r00tkillah/BLINKERCOUGH/pcb/blinkercough.brd

## EAGLE design pcb/blinkercough.brd (2015-08-11)

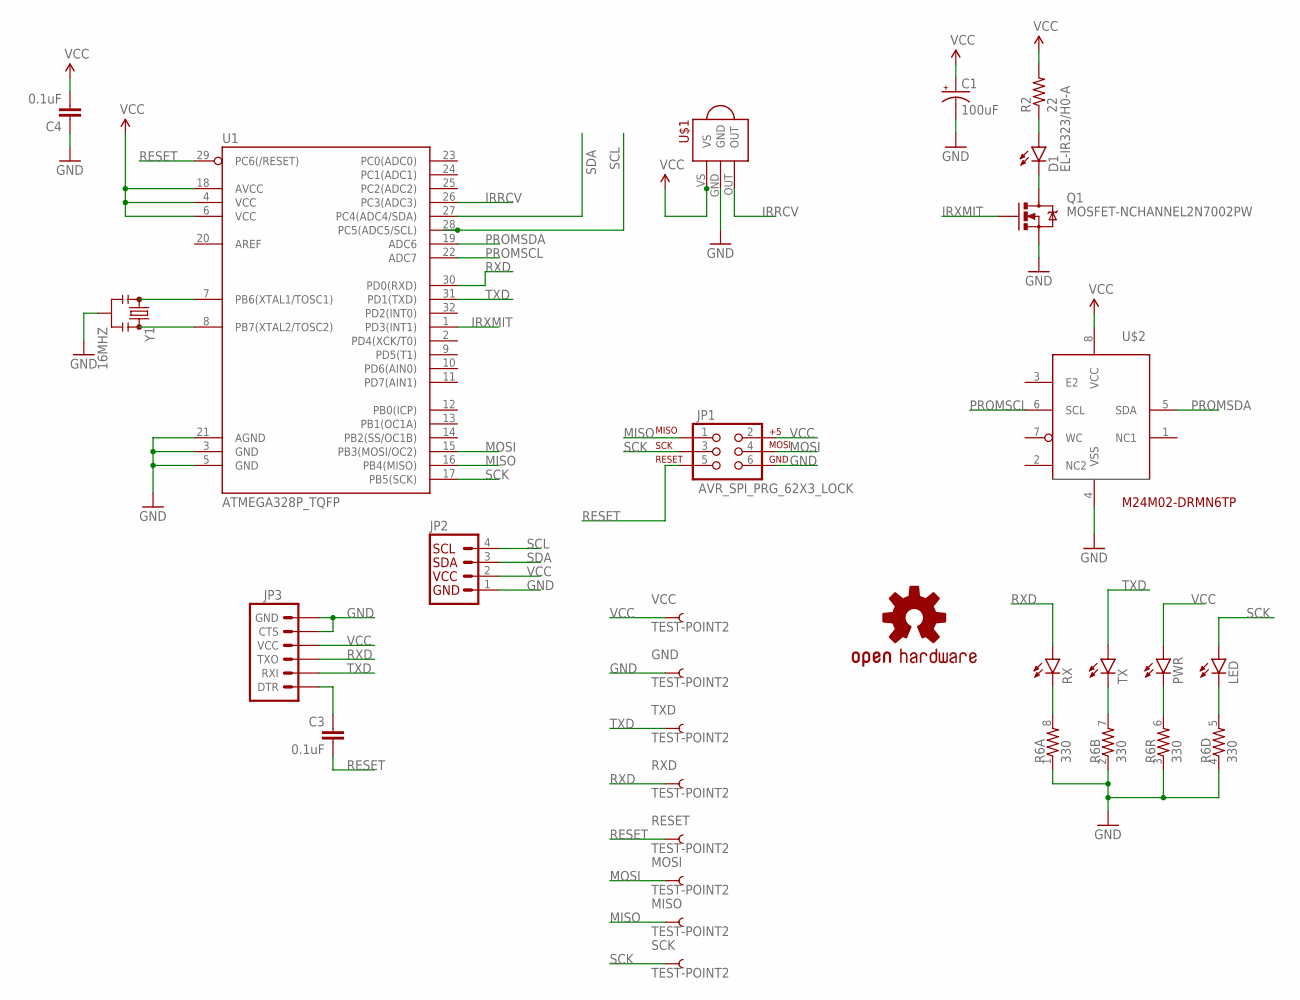
[picture p1: schematic blinkercough.sch]

Parts:
C1: 100uF; EIA7343
C3, C4: 0.1uF; 0603-CAP
D1: EL-IR323/H0-A; LED3MM
GND: TEST-POINT2; PAD.02X.02
JP1: AVR_SPI_PRG_62X3_LOCK; 2X3_LOCK
JP2: I2C_STANDARD; 1X04
JP3: ARDUINO_SERIAL_PROGRAMLOCK; 1X06_LOCK
LED: LED0603; LED-0603
LOGO1: OSHW-LOGOS; OSHW-LOGO-S
MISO: TEST-POINT2; PAD.02X.02
MOSI: TEST-POINT2; PAD.02X.02
PWR: LED0603; LED-0603
Q1: MOSFET-NCHANNEL2N7002PW; SOT323
R2: 22; 1206
R6: 330; 0603-ARV
RESET: TEST-POINT2; PAD.02X.02
RX: LED0603; LED-0603
RXD: TEST-POINT2; PAD.02X.02
SCK: TEST-POINT2; PAD.02X.02
TX: LED0603; LED-0603
TXD: TEST-POINT2; PAD.02X.02
U1: ATMEGA328P_TQFP; TQFP32-08
U$1: TSOP2438
U$2: M24M02-DRMN6TP; SO8
VCC: TEST-POINT2; PAD.02X.02
Y1: 16MHZ; RESONATOR-SMD

Connections:
GND: C1.C (-), C4.1, GND.P$1, JP1.6, JP2.1, JP3.5 (CTS), JP3.6 (GND), Q1.2 (S), R6.1, R6.2 (1), R6.3 (1), R6.4 (1), U1.3 (GND), U1.5 (GND), U1.21 (AGND), U$1.GND, U$2.4 (VSS), Y1.2
IRRCV: U1.26 (PC3(ADC3)), U$1.OUT
IRXMIT: Q1.1 (G), U1.1 (PD3(INT1))
LED: LED.C, R6.5 (2)
MISO: JP1.1, MISO.P$1, U1.16 (PB4(MISO))
MOSI: JP1.4, MOSI.P$1, U1.15 (PB3(MOSI/OC2))
unnamed: U1.7 (PB6(XTAL1/TOSC1)), Y1.1
unnamed: U1.8 (PB7(XTAL2/TOSC2)), Y1.3
unnamed: R6.8 (2), RX.C
unnamed: C3.1, JP3.1 (DTR)
unnamed: D1.K (C), Q1.3 (D)
unnamed: D1.A, R2.1
unnamed: R6.7 (2), TX.C
PROMSCL: U1.22 (ADC7), U$2.6 (SCL)
PROMSDA: U1.19 (ADC6), U$2.5 (SDA)
PWR: PWR.C, R6.6 (2)
RESET: C3.2, JP1.5, RESET.P$1, U1.29 (PC6(/RESET))
RXD: JP3.3 (TXO), RX.A, RXD.P$1, U1.30 (PD0(RXD))
SCK: JP1.3, LED.A, SCK.P$1, U1.17 (PB5(SCK))
SCL: JP2.4, U1.28 (PC5(ADC5/SCL))
SDA: JP2.3, U1.27 (PC4(ADC4/SDA))
TXD: JP3.2 (RXI), TX.A, TXD.P$1, U1.31 (PD1(TXD))
VCC: C1.A (+), C4.2, JP1.2, JP2.2, JP3.4 (VCC), PWR.A, R2.2, U1.4 (VCC), U1.6 (VCC), U1.18 (AVCC), U$1.VS, U$2.8 (VCC), VCC.P$1

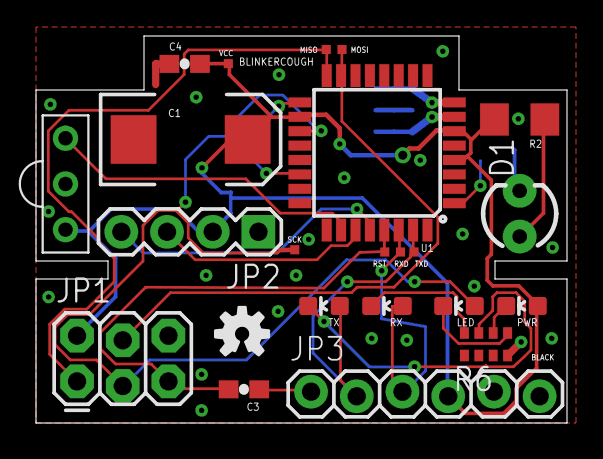
[picture p2: board blinkercough.brd from above]

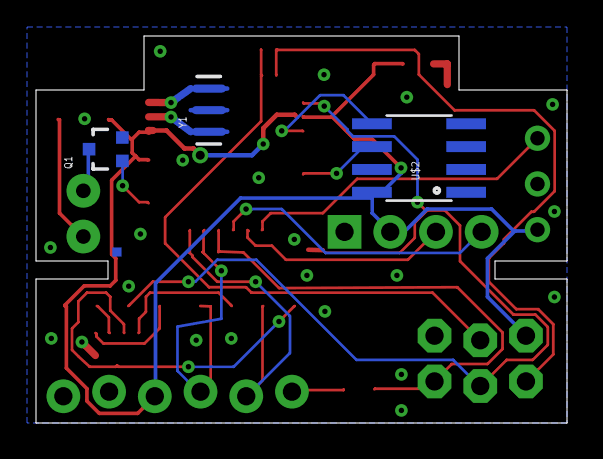
[picture p3: board blinkercough.brd from below]

Board: 2 copper layers, 29.5 x 21.5 mm, 27 parts (4 on the bottom side), 23 nets.
