r00tkillah/BLINKERCOUGH/(commit log)

2015-08-10 Initial public push of BLINKERCOUGH
    BLINKERCOUGH is an NSA Playset project to bridge the airgap without
    radios. This was presented at BSidesLV 2015.
    There are still bugs with this release. This work is not finished.
    [blinkercough.ino, blinkercough.py, codec.h, commander.py, crc16.cpp, crc16.h, i2c.cpp, i2c.h]
2015-08-11 Adding eagle PCB design files
    [blinkercough.brd, blinkercough.sch]
2015-08-23 fix format string screwup in hexdump
    [irframe.cpp]
2015-08-27 Fixes #3
    Actually it was not commander.py, but an off by one buffer length in
    the serial implementation of the registers in the main file.
    [blinkercough.ino]
2015-09-20 correct order of free in hooks
    [blinkercough.ino, i2c.cpp]
2015-09-20 Fix off by one errors
    [i2c.cpp]
2015-09-20 switch to queing bytes via events
    takes queue operations out of the interrupt context in i2c
2015-09-20 zero out frame on alloc/free
2015-09-20 add reset() in some lost cases
    [mac.cpp]
2015-09-20 add debug where print was used
2015-09-20 make packet printing slightly easier to use
2015-09-20 correct sizing errors
    In various ways.. Ought to make this easier to read/use
    [blinkercough.py]
2015-09-25 print in handy hex format
2015-09-25 fix i2c reading
2015-09-27 add new "secret" reset register
    [i2c.cpp]
2015-09-27 don't relay your own packets
